jkerian/psubox/bench supply/bench supply.kicad_pcb

## KiCad design kicad/LPC.sch

Schematic: LPC.sch

Parts:
J2: USB_B_Micro; USB_A_CNCTech_1001-011-01101_Horizontal
LPC1: LPCXPRESSO_LPC1769
