jkerian/psubox/bench supply/bench supply.kicad_pcb

## KiCad design kicad/salida_dac.sch

Schematic: salida_dac.sch

Parts:
R1, R2, R6, R9, R11, R15, R16, R27: 1K; R_Axial_DIN0207_L6.3mm_D2.5mm_P7.62mm_Horizontal
R3, R7, R12: 3K3; R_Axial_DIN0207_L6.3mm_D2.5mm_P7.62mm_Horizontal
R4, R8, R13: 4K7; R_Axial_DIN0207_L6.3mm_D2.5mm_P7.62mm_Horizontal
R5, R10, R14, R17, R24, R26: 10K; R_Axial_DIN0207_L6.3mm_D2.5mm_P7.62mm_Horizontal
R18, R25: 15K; R_Axial_DIN0207_L6.3mm_D2.5mm_P7.62mm_Horizontal
RV1, RV2, RV4, RV5: R_POT; Potentiometer_Bourns_3266Y_Vertical
RV3, RV6, RV7, RV8, RV9, RV10, RV11, RV12: 1K; Potentiometer_Bourns_3266Y_Vertical
U5, U6, U7, U8: 4016; DIP-14_W10.16mm_LongPads

Notes on the sheet:
Salida DAC uC de 0 a 3V Salida módulo amplificador: 0V = VEE (-5V) 1.5V = 0V 3V = VCC (5V)
Salida electrodo: VEE<0<VCC Entrada ADC: 0 a 5V (eventualmente 0 a 3.3V)
Amplificador Tension Inversor con selector de ganancia y offset (AMP T1)
Amplificador Tension Inversor con selector de ganancia y offset (AMP T2)
El offset de este amplificador se regulará para tener valor medio nulo
El offset de este amplificador se regulará para tener valor medio igual a la mitad del rango del ADC (0 a 3.3V)
Amplificador Tension Inversor con selector de ganancia y offset (AMP I2)
