jkerian/psubox/(commit log)

2021-05-01 A power supply design.
    [PSU Panel.scad, bench supply.kicad_pcb, bench supply.sch]
2021-05-01 Adding chamcube module and readme corrections
    [PSU Panel.scad]
2021-11-11 Update README.md
    Add XT60 connector to wishlist
